ruben-wilssens/master_20-21/Code flowcharts/Packet_contents.pdf

Pkt length | Pkt type | Dest_ID | Source_ID | Audio samples (encrypted with voice key) | RSSI
Pkt length | Pkt type | Dest_ID | Source_ID | Voice key (encrypted with network key) | RSSI
Pkt length | Pkt type | Dest_ID | Source_ID | RSSI
Pkt length | Pkt type | Dest_ID | Source_ID | Audio samples | RSSI

Audio

Encrypted audio

Audio key

Keybit chosen

Pkt length | Pkt type | Dest_ID | Source_ID | RSSI

Keybit +Hamming
Hamming
Pkt length | Pkt type | Dest_ID | Source_ID | RSSI

Keybit +CRC
CRC
Pkt length | Pkt type | Dest_ID | Source_ID | RSSI

Keybit CRC response

Pkt length | Pkt type | Dest_ID | Source_ID | RSSI

Reply

Hamming | Index
