ruben-wilssens/master_20-21/Code flowcharts/Multi-user_flowchart.pdf

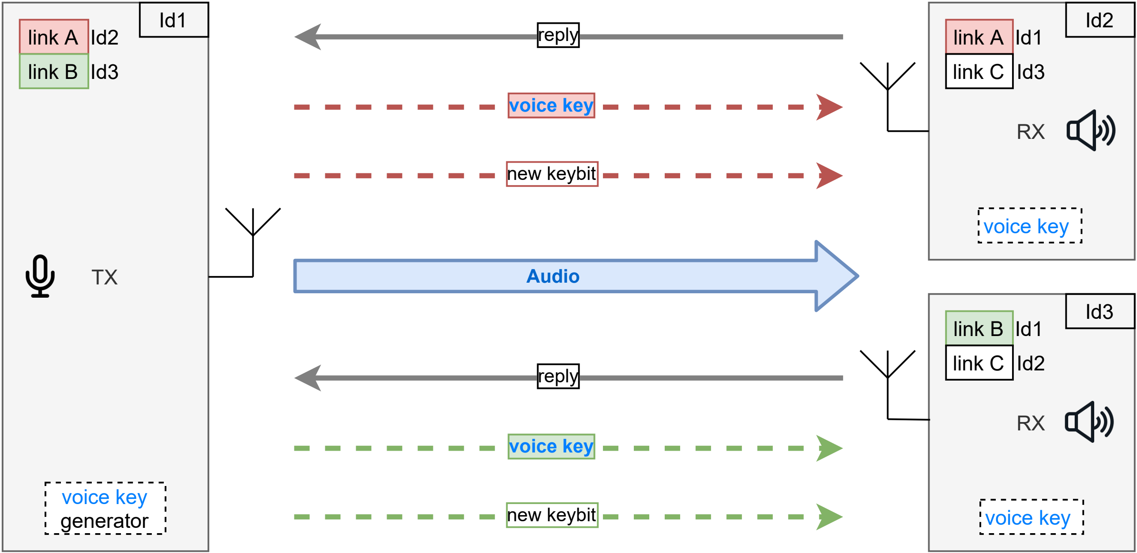
[picture p2: figure]
link A; link B; Audio; voice key generator; voice key; link C reply; new keybit; link C; reply
