ruben-wilssens/master_20-21/Images/PCB_bottom.png

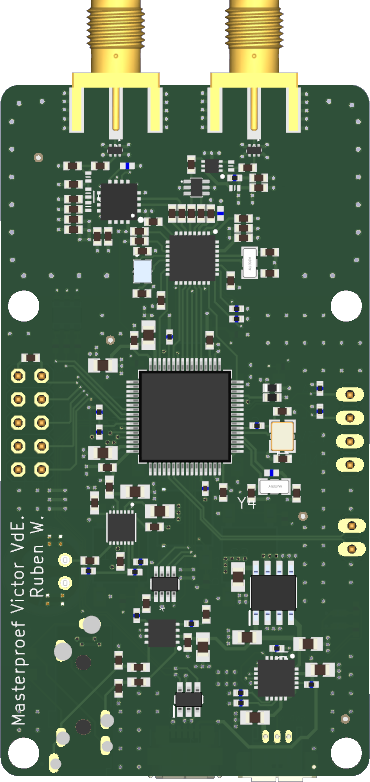
Images/PCB_bottom.png
