ruben-wilssens/master_20-21/Images/PCB_bottom_angle.png

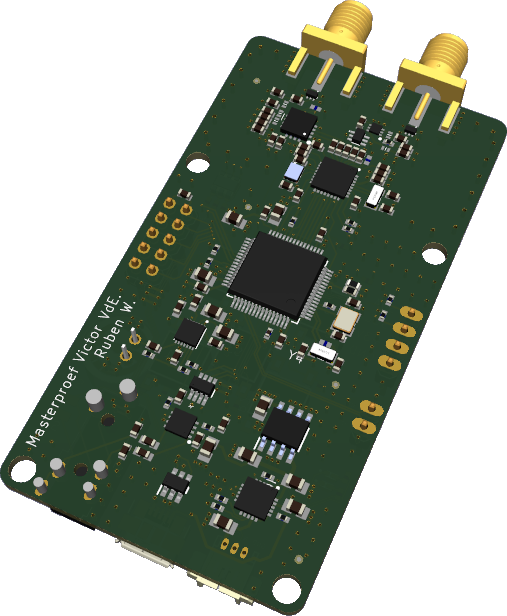
Images/PCB_bottom_angle.png
