ruben-wilssens/master_20-21/Images/PCB_top.png

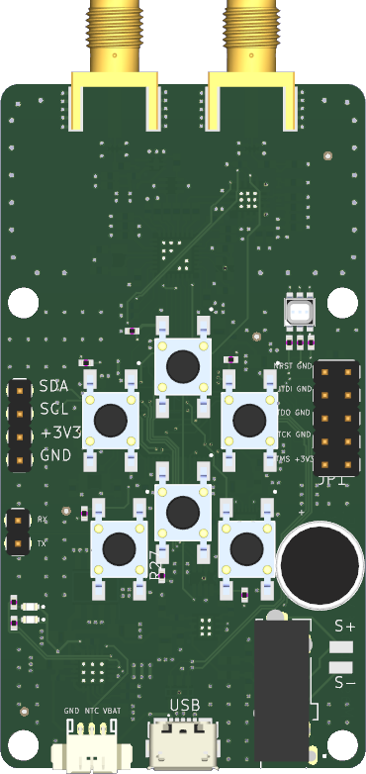
Images/PCB_top.png
