ruben-wilssens/master_20-21/Images/PCB_top_angle.png

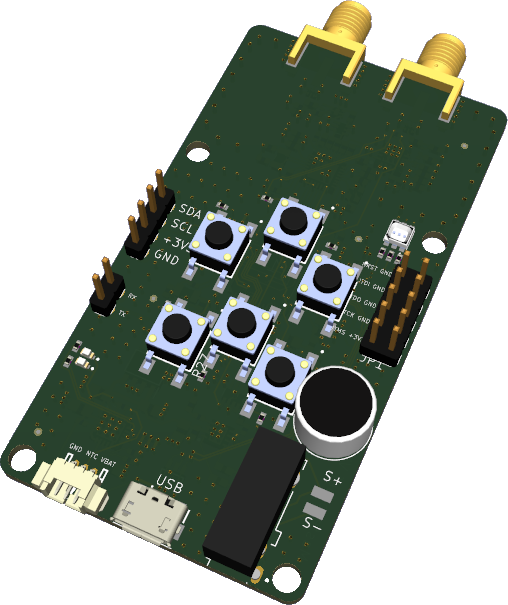
Images/PCB_top_angle.png
