ruben-wilssens/master_20-21/Code flowcharts/Abstract_code_flowchart.pdf

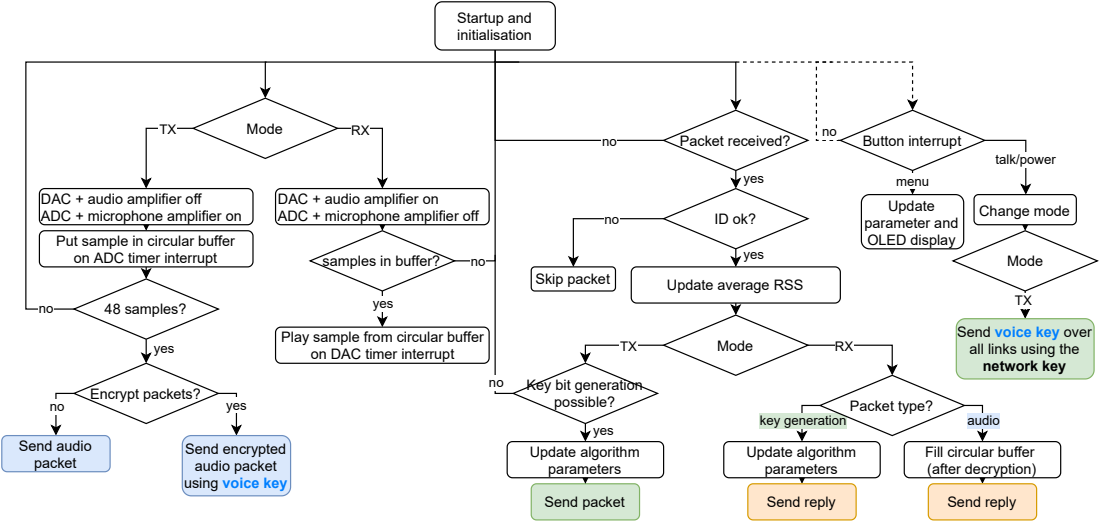
[picture p7: page 1]
Startup and initialisation; Mode; Skip packet; Update average RSS; yes; 48 samples?; Encrypt packets?; Send audio packet; Packet received?; key generation; audio; Packet type?; Update algorithm parameters; Key bit generation; possible?; Send packet; Send reply; menu; talk/power; Button interrupt; Update parameter and OLED display; Change mode

DAC + audio amplifier off
ADC + microphone amplifier on
Put sample in circular buffer
on ADC timer interrupt

DAC + audio amplifier on
ADC + microphone amplifier off

samples in buffer?

Send voice key over
all links using the
network key

Play sample from circular buffer
on DAC timer interrupt

Send encrypted
audio packet
using voice key

Fill circular buffer
(after decryption)
