ruben-wilssens/master_20-21/Code flowcharts/RX_mode_flowchart.pdf

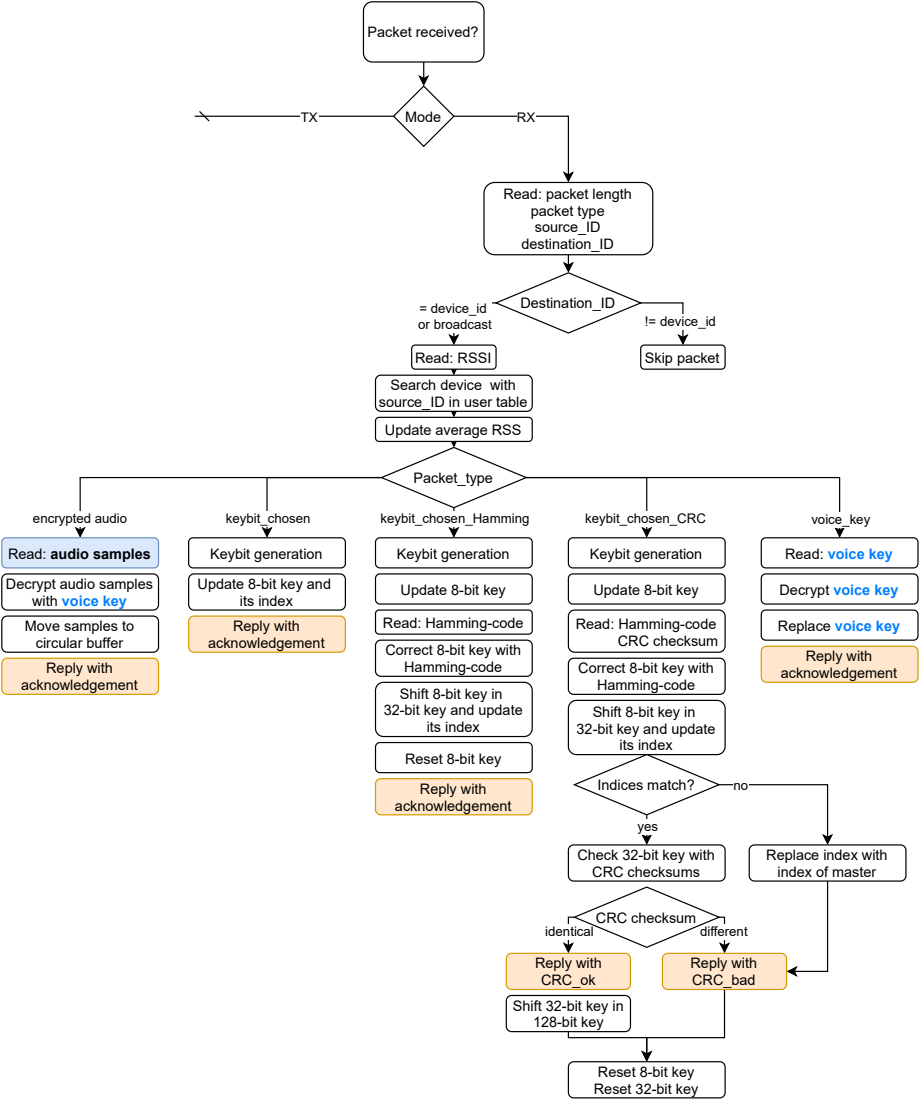
[picture p8: page 1]
Packet received?; Mode; Read: packet length packet type source_ID destination_ID; != device_id; = device_id or broadcast; Destination_ID; Read: RSSI; Skip packet; encrypted audio; keybit_chosen; keybit_chosen_Hamming; keybit_chosen_CRC; voice_key; Packet_type; Keybit generation; identical; different; CRC checksum; Reply with CRC_bad; yes; Indices match?

Search device with
source_ID in user table
Update average RSS

Read: audio samples
Decrypt audio samples
with voice key
Move samples to
circular buffer
Reply with
acknowledgement

Update 8-bit key and
its index

Read: voice key

Update 8-bit key

Decrypt voice key

Read: Hamming-code
Correct 8-bit key with
Hamming-code
Shift 8-bit key in
32-bit key and update

CRC checksum

Replace voice key

Reset 8-bit key

Check 32-bit key with
CRC checksums

Replace index with
index of master

CRC_ok
Shift 32-bit key in
128-bit key

Reset 32-bit key
