ruben-wilssens/master_20-21/Code flowcharts/TX_mode_flowchart.pdf

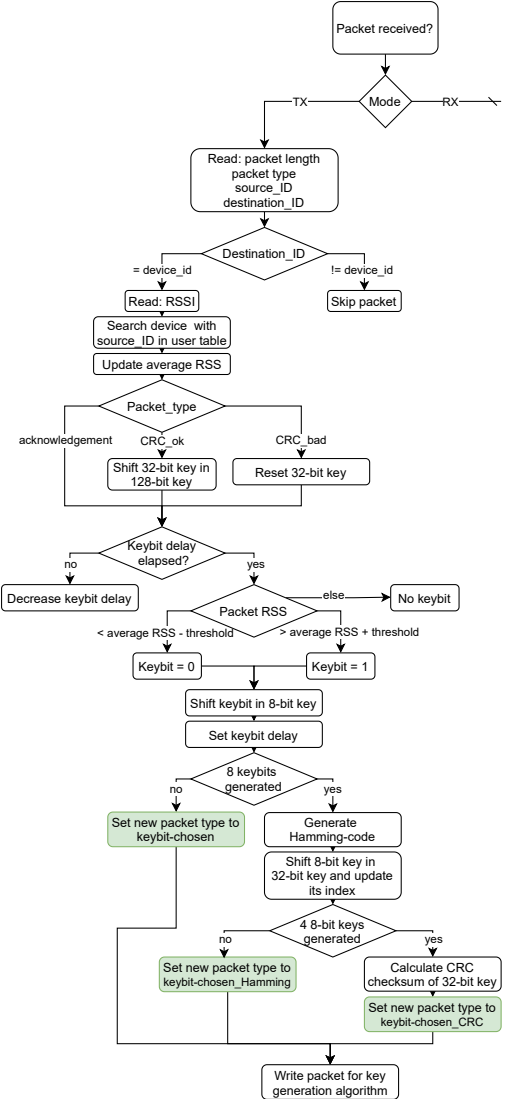
[picture p9: page 1]
Packet received?; Read: packet length packet type source_ID destination_ID; = device_id; != device_id; Destination_ID; Mode; Read: RSSI; Skip packet; acknowledgement; CRC_ok; CRC_bad; Packet_type; yes; Keybit delay elapsed?; < average RSS - threshold; > average RSS + threshold; else; Packet RSS; Keybit = 0; Keybit = 1; 8 keybits generated; 4 8-bit keys generated; No keybit

Search device with
source_ID in user table
Update average RSS

Shift 32-bit key in
128-bit key

Reset 32-bit key

Decrease keybit delay

Shift keybit in 8-bit key

Set keybit delay

Set new packet type to
keybit-chosen

Generate
Hamming-code
Shift 8-bit key in
32-bit key and update
its index

keybit-chosen_Hamming

Calculate CRC
checksum of 32-bit key
keybit-chosen_CRC

Write packet for key
generation algorithm
