ruben-wilssens/master_20-21/Master_1.0/Core/Src/main.c

/*
 *  main.c
 *
 *  Created on: February 2021
 *  Author: Ruben Wilssens & Victor Van der Elst
 *
 */

/* Includes ------------------------------------------------------------------*/
#include "main.h"
#include "usb_device.h"

/* USER CODE BEGIN Includes */
#include "usbd_cdc_if.h"
#include "ssh1106.h"
#include "OLED.h"
#include <math.h>
#include "CBUF.h"
#include "string.h"
/* USER CODE END Includes */

/* USER CODE BEGIN PTD */
typedef struct{
	uint8_t ID;						// network ID
	uint32_t RSSI_counter;			// received packets
	uint16_t RSSI_Mean;				// exponential moving average
	double RSSI_Mean_Double;

	uint8_t keybits_8bit;			// current number of bits of 8-bit key
	uint8_t key_8bit;				// current 8-bit key

	uint8_t keybytes_32bit;			// current number of new 8-bit keys in 32-bit key
	uint32_t key_32bit;				// current 32-bit key
	uint16_t key_counter_32bit;		// number of generated 32-bit keys

	uint8_t keywords_128bit;		// index for new 32-bit keys in 128-bit key
	uint32_t key_128bit[4];			// current 128-bit key
	uint32_t key_CRC_128bit[4];		// new 128-bit key with new 32-bit
	uint16_t key_counter;			// number of generated 128-bit keys

	uint8_t key_chosen_wait_timer;	// delay for new keybit
} device;

// Pointer to device struct
device *ptrdev;

device devices[] = {
{
		ID: 0x01,
		RSSI_counter: 0x00,
		RSSI_Mean: 0x0000,
		RSSI_Mean_Double:  0,
		keybits_8bit: 0,
		key_8bit: 0xA1,
		keybytes_32bit: 0,
		key_32bit: 0x80808080,
		key_counter_32bit: 0,
		keywords_128bit: 0,
		key_128bit: {0x2B7E1516,0x28AED2A6,0xABF71588,0x09CF4F3C},
		key_CRC_128bit: {0x2B7E1516,0x28AED2A6,0xABF71588,0x09CF4F3C},
		key_counter: 0x00,
		key_chosen_wait_timer: 0
},
{
		ID: 0x02,
		RSSI_counter: 0x00,
		RSSI_Mean: 0x0000,
		RSSI_Mean_Double:  0,
		keybits_8bit: 0,
		key_8bit: 0xA1,
		keybytes_32bit: 0,
		key_32bit: 0x80808080,
		key_counter_32bit: 0,
		keywords_128bit: 0,
		key_128bit: {0x2B7E1516,0x28AED2A6,0xABF71588,0x09CF4F3C},
		key_CRC_128bit: {0x2B7E1516,0x28AED2A6,0xABF71588,0x09CF4F3C},
		key_counter: 0x00,
		key_chosen_wait_timer: 0
}};

/* USER CODE END PTD */

/* USER CODE BEGIN PD */
volatile uint32_t time_start, time_end, time_diff;
#define TIME_MEASURE_START time_start = SysTick->VAL
#define TIME_MEASURE_STOP time_end = SysTick->VAL; \
		time_diff = time_start - time_end

/*
// Start point for SysTick
HAL_SYSTICK_Config(0xFFFFFFF);
TIME_MEASURE_START;
...
TIME_MEASURE_STOP;
*/

/* USER CODE END PD */

ADC_HandleTypeDef hadc1;

CRC_HandleTypeDef hcrc;

CRYP_HandleTypeDef hcryp;
__ALIGN_BEGIN static const uint32_t pKeyCRYP[4] __ALIGN_END = {
                            0x2B7E1516,0x28AED2A6,0xABF71588,0x09CF4F3C};

DAC_HandleTypeDef hdac;

I2C_HandleTypeDef hi2c1;

RTC_HandleTypeDef hrtc;

SPI_HandleTypeDef hspi1;
SPI_HandleTypeDef hspi2;

TIM_HandleTypeDef htim1;
TIM_HandleTypeDef htim2;
TIM_HandleTypeDef htim3;
TIM_HandleTypeDef htim5;
TIM_HandleTypeDef htim7;
TIM_HandleTypeDef htim9;
TIM_HandleTypeDef htim11;

UART_HandleTypeDef huart5;

/* USER CODE BEGIN PV */

/* ---Default settings--- */

char settings_mode = 'R';						// mode can be R (RX) or T (TX)
#define settings_audiosamples_length 48			// samplecount per audio packet -> packetrate = 8000^-1 * settings_audiosamples_length
uint8_t settings_volume = 30;					// digipot volume (keep < 50)
uint8_t HGM = 0;								// 0 = LGM LNA, 1 = HGM LNA
uint8_t settings_encryption = 1;				// 0 = off, 1 = on
uint8_t settings_threshold = 3;					// threshold for choosing keybits
double ALPHA = 0.1;								// weighting factor exponential moving average
const uint8_t settings_keybit_delay = 4;		// packets between new possible keybit



uint8_t encryption_byte = 0;					// new packet type

uint8_t dest_ID = 0xFF;							// current destination address
const uint8_t source_ID = 0x01;					// identification address device
const uint8_t broadcast_ID = 0xFF;				// broadcast address

uint8_t transmit_voice_key = 0;
const uint32_t voice_key_device[4] 	= {0x2B7E1516,0x28AED2A6,0xABF71588,0x09CF4F3C}; // voice key of device (extra: generate new one with RNG)
uint32_t voice_key[4] 				= {0x2B7E1516,0x28AED2A6,0xABF71588,0x09CF4F3C}; // current active voice key

/* ---OLED Variabels--- */
uint8_t settings_debugscreen = 0; 						// debug flag (unused)
uint8_t LBO = 1;										// low battery indicator flag
uint8_t menu = 4; 										// menu flag: 4 = credit screen
uint8_t update_oled = 0;								// OLED update flag
uint8_t settings_USB_print = 0;							// 0 = print new 32-bit key, 1 = print received RSS,

/* ---Packet settings--- */
const uint8_t packet_type_audio = 0xFE;
const uint8_t packet_type_audio_encrypted = 0xFF;
const uint8_t packet_type_voice_key = 0xBF;

const uint8_t packet_type_keybit_chosen = 0xAA;			// keybit chosen by TX
const uint8_t packet_type_keybit_chosen_Hamming = 0xAB; // 8th keybit chosen by TX + Hamming
const uint8_t packet_type_keybit_chosen_CRC = 0xAC; 	// 8th keybit chosen by TX + Hamming (4th byte) + CRC

const uint8_t packet_type_keybit_CRC_ok = 0xA0;			// CRC ok reply by RX
const uint8_t packet_type_keybit_CRC_bad = 0xB0;		// CRC bad reply by RX

const uint8_t packet_type_reply = 0x0F;

/* ---Packet reception (read)--- */
uint8_t Rx_packet_length;
uint8_t Rx_packet_type;
uint8_t Rx_from_ID;
uint8_t Rx_to_ID;
uint8_t Rx_data_length;
uint8_t Hamming;
uint32_t CRC_sum;
uint32_t CRC_c;
uint8_t CRC_array[4];
uint8_t keyword_index;
uint8_t Rx_RSSI;

uint8_t packet_valid;

/* ---External interrupts--- */
uint8_t INT_PACKET_RECEIVED = 0;				// ADF7242 interrupt
uint8_t INT_PACKET_SENT = 0;					// ADF7242 interrupt
uint16_t packets_received = 0;
uint16_t packets_received_prev = 0;
uint16_t packets_sent = 0;
uint16_t packets_sent_prev = 0;
uint32_t RSSI_prev = 0;

/* ---Button states for debouncing--- */
static volatile int POWER_state = 1;
static volatile int TALK_state = 1;
static volatile int UP_state = 1;
static volatile int DOWN_state = 1;
static volatile int LEFT_state = 1;
static volatile int RIGHT_state = 1;

uint8_t setup_switch = 0;						// hacking code (Tx->Rx bug)


/* ---Audio--- */
uint8_t adc_value = 0;
uint16_t adc_value_downsampled = 0;
uint32_t adc_counter = 0;
cbuf_handle_t audio_buffer_handle_t;
uint16_t cbuf_size = 0;
uint8_t data[settings_audiosamples_length];
uint8_t samples[settings_audiosamples_length];

/* ---Transceiver variables--- */
const uint32_t settings_frequency = 245000;		// ADF7242 frequency in [Hz/10kHz] -> 2,45 GHz
// Buffer starting address
uint8_t RX_BUFFER_BASE;
uint8_t TX_BUFFER_BASE;

uint8_t ADF_status;								// SPI status word return ADF7242


/* USER CODE END PV */

void SystemClock_Config(void);
static void MX_GPIO_Init(void);
static void MX_ADC1_Init(void);
static void MX_DAC_Init(void);
static void MX_I2C1_Init(void);
static void MX_SPI1_Init(void);
static void MX_SPI2_Init(void);
static void MX_TIM1_Init(void);
static void MX_TIM3_Init(void);
static void MX_UART5_Init(void);
static void MX_RTC_Init(void);
static void MX_TIM5_Init(void);
static void MX_TIM11_Init(void);
static void MX_TIM2_Init(void);
static void MX_TIM7_Init(void);
static void MX_TIM9_Init(void);
static void MX_CRYP_Init(void);
static void MX_CRC_Init(void);
/* USER CODE BEGIN PFP */

void HAL_GPIO_EXTI_Callback(uint16_t);					// external interrupt callback
void HAL_TIM_PeriodElapsedCallback(TIM_HandleTypeDef *);// timer elapsed callback
void HAL_ADC_ConvCpltCallback(ADC_HandleTypeDef*);		// ADC conversion complete callback

void startup(void);										// startup init device
void setup(void);										// setup device, display & transceiver

void digipotInit(uint8_t);								// set digipot volume
void LED_RGB_status(uint16_t , uint16_t , uint16_t );	// set RGB led color

void playAudio(void);									// transfer samples from audio buffer to DAC

void transmitVoiceKey(device *ptrdev);					// transmit voice key when becoming TX
void transmitAudioPacket(void);							// transmit audio packet if buffer filled with 48 packets
uint8_t readPacket(void);								// read received packet

void writeKeybitPacket(device*, uint8_t);				// write packet for network key generation

uint8_t Hamming_create(uint8_t);						// create parity bits of Hamming-code from 8-bit key
uint8_t Hamming_correct(uint8_t, uint8_t);				// correct 8-bit key with parity bits

void CRC_create(device*);								// create CRC checksum of new 128-bit network key with inserted 32-bit key
uint8_t CRC_check(device*);								// create CRC checksums

/* USER CODE END PFP */

/**
  * @brief  The application entry point.
  * @retval int
  */
int main(void)
{
  /* MCU Configuration--------------------------------------------------------*/

  /* Reset of all peripherals, Initializes the Flash interface and the Systick. */
  HAL_Init();

  /* Configure the system clock */
  SystemClock_Config();

  /* Initialize all configured peripherals */
  MX_GPIO_Init();
  MX_ADC1_Init();
  MX_DAC_Init();
  MX_I2C1_Init();
  MX_SPI1_Init();
  MX_SPI2_Init();
  MX_TIM1_Init();
  MX_TIM3_Init();
  MX_USB_DEVICE_Init();
  MX_UART5_Init();
  MX_RTC_Init();
  MX_TIM5_Init();
  MX_TIM11_Init();
  MX_TIM2_Init();
  MX_TIM7_Init();
  MX_TIM9_Init();
  MX_CRYP_Init();
  MX_CRC_Init();
  /* USER CODE BEGIN 2 */

  HAL_TIM_Base_Start(&htim7);

  // Start PWM timers for RGB led
  HAL_TIM_PWM_Start(&htim1, TIM_CHANNEL_1);
  HAL_TIM_PWM_Start(&htim3, TIM_CHANNEL_3);
  HAL_TIM_PWM_Start(&htim3, TIM_CHANNEL_4);

  LED_RGB_status(0, 0, 35);

  startup();
  digipotInit(settings_volume);

  // USB VCP variables
  int8_t buffer[60]; //25

  ptrdev= &devices[0];

  /* USER CODE END 2 */

  /* Infinite loop */
  /* USER CODE BEGIN WHILE */
  while (1){
	  if(transmit_voice_key){
		  HAL_Delay(1);
		  for(int i=0; i<sizeof(devices)/sizeof(devices[0]); i++){
			  transmitVoiceKey(&devices[i]);
			  HAL_Delay(2);
		  }
		  transmit_voice_key = 0;
	  }

	  if(setup_switch==1){
		  HAL_Delay(20);
		  ADF_set_Rx_mode();
		  setup_switch=0;
	  }

	  if (INT_PACKET_RECEIVED){
		  ADF_clear_Rx_flag(); //test
		  while(ADF_SPI_READY()==0);
		  INT_PACKET_RECEIVED = 0;

		  if (settings_mode == 'R'){
			  ADF_set_Rx_mode(); //added
			  while(ADF_SPI_READY()==0);
			  packet_valid = readPacket();

			  if(packet_valid){
				  // Point to correct device with Rx_from_ID
				  if(Rx_from_ID < sizeof(devices)/sizeof(devices[0])){
					  if(Rx_from_ID == devices[Rx_from_ID].ID){
						  ptrdev = &devices[Rx_from_ID];
					  }
				  }
				  else{
					  //throw error + do not execute code below
				  }
				  if (!(ptrdev->RSSI_counter)){
					  ptrdev->RSSI_Mean_Double = Rx_RSSI;
					  ptrdev->RSSI_Mean = round(ptrdev->RSSI_Mean_Double);
				  }
				  else{
					  ptrdev->RSSI_Mean_Double = (ALPHA*Rx_RSSI) + ((1-ALPHA)*ptrdev->RSSI_Mean_Double);
					  ptrdev->RSSI_Mean = round(ptrdev->RSSI_Mean_Double);
				  }
				  (ptrdev->RSSI_counter)++;


				  if(settings_USB_print == 1){
					  // Transmit RSS & RSS_Mean over USB
					  sprintf(buffer, "R,%d,%d\r\n", (int8_t) Rx_RSSI, (int8_t) ptrdev->RSSI_Mean);
					  CDC_Transmit_FS((int8_t *)buffer, strlen(buffer));
				  }


				  if(Rx_packet_type == packet_type_keybit_chosen){
					  // Generate new keybit
					  if(Rx_RSSI <= ptrdev->RSSI_Mean){
						  if(ptrdev->keybits_8bit < 8){
							  (ptrdev->key_8bit) = ((ptrdev->key_8bit)<<1) | 0;
							  (ptrdev->keybits_8bit)++;
						  }
					  }
					  else if(Rx_RSSI > ptrdev->RSSI_Mean){
						  if(ptrdev->keybits_8bit < 8){
							  (ptrdev->key_8bit) = ((ptrdev->key_8bit)<<1) | 1;
							  (ptrdev->keybits_8bit)++;
						  }
					  }

					  encryption_byte = packet_type_reply;
				  }

				  else if(Rx_packet_type == packet_type_keybit_chosen_Hamming){
					  // Generate last keybit of 8-bit key
					  if(Rx_RSSI <= ptrdev->RSSI_Mean){
						  (ptrdev->key_8bit) = ((ptrdev->key_8bit)<<1) | 0;
					  }
					  else if(Rx_RSSI > ptrdev->RSSI_Mean){
						  (ptrdev->key_8bit) = ((ptrdev->key_8bit)<<1) | 1;
					  }

					  // Do a Hamming correction with Rx_Hamming_code
					  (ptrdev->key_8bit) = Hamming_correct(Hamming, ptrdev->key_8bit);

					  // Shift 8-bit key in 32-bit key + update parameters
					  ptrdev->key_32bit = ((ptrdev->key_32bit)<<8) | (ptrdev->key_8bit);
					  ptrdev->key_8bit = 0;
					  ptrdev->keybits_8bit = 0;
					  (ptrdev->keybytes_32bit)++;

					  encryption_byte = packet_type_reply;


					  /*
					  // Transmit over USB
					  uint8_t TxBuf[34];
					  sprintf(TxBuf, "R;%lu\r\n", (unsigned long) (ptrdev->key_32bit));
					  CDC_Transmit_FS((int8_t *)TxBuf, strlen(TxBuf));
					  */
				  }

				  else if(Rx_packet_type == packet_type_keybit_chosen_CRC){
					  // Generate last keybit of 8-bit key
					  if(Rx_RSSI <= ptrdev->RSSI_Mean){
						  (ptrdev->key_8bit) = ((ptrdev->key_8bit)<<1) | 0;
					  }
					  else if(Rx_RSSI > ptrdev->RSSI_Mean){
						  (ptrdev->key_8bit) = ((ptrdev->key_8bit)<<1) | 1;
					  }

					  // Do a Hamming correction with Rx_Hamming_code
					  (ptrdev->key_8bit) = Hamming_correct(Hamming, ptrdev->key_8bit);

					  // Shift 8-bit key in 32-bit key + update parameters
					  ptrdev->key_32bit = ((ptrdev->key_32bit)<<8) | (ptrdev->key_8bit);
					  ptrdev->key_8bit = 0;
					  ptrdev->keybits_8bit = 0;
					  (ptrdev->keybytes_32bit) = 0;

					  if(settings_USB_print == 0){
						  // Transmit key over USB
						  uint8_t TxBuf[60];
						  sprintf(TxBuf, "R;%lu\r\n", (unsigned long) (ptrdev->key_32bit));
						  CDC_Transmit_FS((int8_t *)TxBuf, strlen(TxBuf));
					  }

					  if(keyword_index != ptrdev->keywords_128bit){
						  // There is a missmatch in key index (because CRC_reply did not arrive)
						  ptrdev->keywords_128bit = keyword_index;
						  for(int i=0; i<4; i++){
							  ptrdev->key_CRC_128bit[i] = ptrdev->key_128bit[i];
						  }
					  }

					  // Generate CRC of new Rx-key + do CRC check with Tx CRC
					  ptrdev->key_CRC_128bit[ptrdev->keywords_128bit] = ptrdev->key_32bit;

					  if(CRC_check(ptrdev)==1){
						  // Insert 32-bit key in 128-bit key
						  ptrdev->key_128bit[ptrdev->keywords_128bit]=ptrdev->key_32bit;
						  // Update the 128-bit key index
						  (ptrdev->keywords_128bit)++;
						  if(ptrdev->keywords_128bit>3){
							  ptrdev->keywords_128bit = 0;
						  }
						  (ptrdev->key_counter)++;

						  encryption_byte = packet_type_keybit_CRC_ok;
					  }
					  else{
						  encryption_byte = packet_type_keybit_CRC_bad;
					  }
				  }

				  else if(Rx_packet_type == packet_type_audio_encrypted){
					  hcryp.Init.pKey = voice_key;
					  HAL_CRYP_Decrypt(&hcryp, data, settings_audiosamples_length, samples, 50);
					  for(uint8_t i = 0; i < settings_audiosamples_length; i++){
						  circular_buf_put_overwrite(audio_buffer_handle_t, samples[i]);
					  }
					  encryption_byte = packet_type_reply;
				  }
				  else if(Rx_packet_type == packet_type_audio){
					  for(uint8_t i = 0; i < settings_audiosamples_length; i++){
						  circular_buf_put_overwrite(audio_buffer_handle_t, data[i]);
					  }
					  encryption_byte = packet_type_reply; // not necessary, should be deleted
				  }

				  if(encryption_byte !=0){
					  writeKeybitPacket(ptrdev, encryption_byte);
					  encryption_byte = 0;
				  }

				  /*
				  // Transmit RSS & RSS_Mean over USB
				  sprintf(buffer, "%d,%d\r\n", (int8_t) Rx_RSSI, (int8_t) ptrdev->RSSI_Mean);
				  CDC_Transmit_FS((int8_t *)buffer, strlen(buffer));
				*/
			  }
		  }

		  else if (settings_mode == 'T'){
			  ADF_set_Rx_mode();
			  packet_valid = readPacket();
			  if((Rx_to_ID == source_ID) && packet_valid == 1){
				  // Point to correct device with Rx_from_ID
				  if(Rx_from_ID < sizeof(devices)/sizeof(devices[0]) && Rx_from_ID == devices[Rx_from_ID].ID){
					  ptrdev = &devices[Rx_from_ID];
				  }
				  else{
					  //throw error + do not execute code below
				  }
				  if (!(ptrdev->RSSI_counter)){
					  ptrdev->RSSI_Mean_Double = Rx_RSSI;
					  ptrdev->RSSI_Mean = round(ptrdev->RSSI_Mean_Double);
				  }
				  else{
					  ptrdev->RSSI_Mean_Double = (ALPHA*Rx_RSSI) + ((1-ALPHA)*ptrdev->RSSI_Mean_Double);
					  ptrdev->RSSI_Mean = round(ptrdev->RSSI_Mean_Double);
				  }
				  (ptrdev->RSSI_counter)++;


				  if(settings_USB_print == 1){
					  // Transmit RSS & RSS_Mean over USB
					  sprintf(buffer, "T,%d,%d\r\n", (int8_t) Rx_RSSI, (int8_t) ptrdev->RSSI_Mean);
					  CDC_Transmit_FS((int8_t *)buffer, strlen(buffer));
				  }


				  // ---Key generation algorithm TX---
				  // Wait for 100 RSSI values
				  if(ptrdev->RSSI_counter > 100){
					  // Delay for new keybit is passed
					  if (ptrdev->key_chosen_wait_timer == 0){
						  // RSS below threshold -> keybit = 0
						  if (Rx_RSSI < (ptrdev->RSSI_Mean - settings_threshold)){
							  if ((ptrdev->keybits_8bit) < 8){
								  ptrdev->key_8bit = ((ptrdev->key_8bit)<<1) | 0;
								  (ptrdev->keybits_8bit)++;
								  ptrdev->key_chosen_wait_timer = settings_keybit_delay;

								  encryption_byte = packet_type_keybit_chosen;
							  }
						  }
						  // RSS above threshold -> keybit = 1
						  else if (Rx_RSSI > (ptrdev->RSSI_Mean + settings_threshold)){
							  if ((ptrdev->keybits_8bit) < 8){
								  ptrdev->key_8bit = ((ptrdev->key_8bit)<<1) | 1;
								  (ptrdev->keybits_8bit)++;
								  ptrdev->key_chosen_wait_timer = settings_keybit_delay;

								  encryption_byte = packet_type_keybit_chosen;
							  }
						  }
					  }
					  else{
						  (ptrdev->key_chosen_wait_timer)--;
					  }

					  // Hamming
					  if(ptrdev->keybits_8bit == 8){
						  // Prepare Hamming-code
						  Hamming = Hamming_create(ptrdev->key_8bit);

						  // Shift 8-bit key in 32-bit key
						  ptrdev->key_32bit = ((ptrdev->key_32bit)<<8) | (ptrdev->key_8bit);
						  // Reset 8-bit key
						  ptrdev->key_8bit = 0;
						  ptrdev->keybits_8bit = 0;
						  // Update number of 8-bit keys in 32-bit key
						  (ptrdev->keybytes_32bit)++;

						  encryption_byte = packet_type_keybit_chosen_Hamming;
						  /*
						  // Transmit 32-bit key over USB
						  uint8_t TxBuf[34];
						  sprintf(TxBuf, "T;%lu\r\n", (unsigned long) (ptrdev->key_32bit));
						  CDC_Transmit_FS((int8_t *)TxBuf, strlen(TxBuf));
						  */
					  }

					  // CRC
					  if(ptrdev->keybytes_32bit == 4){
						  // calculate CRC
						  ptrdev->key_CRC_128bit[ptrdev->keywords_128bit] = ptrdev->key_32bit;
						  CRC_create(ptrdev);

						  // Update number of "new" 32-bit keys
						  (ptrdev->key_counter_32bit)++;
						  (ptrdev->keybytes_32bit) = 0;

						  if(settings_USB_print == 0){
							  // Transmit key over USB
							  uint8_t TxBuf[60];
							  sprintf(TxBuf, "T;%lu\r\n", (unsigned long) (ptrdev->key_32bit));
							  CDC_Transmit_FS((int8_t *)TxBuf, strlen(TxBuf));
						  }

						  encryption_byte = packet_type_keybit_chosen_CRC;
					  }
				  }

				  if(Rx_packet_type == packet_type_keybit_CRC_ok){
					  // Insert matching 32-bit key in 128-bit key
					  ptrdev->key_128bit[ptrdev->keywords_128bit]=ptrdev->key_32bit;
					  // Update the 128-bit key index
					  (ptrdev->keywords_128bit)++;
					  if(ptrdev->keywords_128bit>3){
						  ptrdev->keywords_128bit = 0;
					  }
					  (ptrdev->key_counter)++;

					  /*
					  // Transmit 32-bit key over USB
					  uint8_t TxBuf[34];
					  sprintf(TxBuf, "T;%lu\r\n", (unsigned long) (ptrdev->key_32bit));
					  CDC_Transmit_FS((int8_t *)TxBuf, strlen(TxBuf));
					  */
				  }

				  else if(Rx_packet_type == packet_type_keybit_CRC_bad){
					  asm("nop");;
				  }

				  if(encryption_byte !=0){
					  HAL_Delay(1);
					  writeKeybitPacket(ptrdev, encryption_byte);
					  encryption_byte = 0;
				  }

				  /*
				  // Transmit RSS & RSS_Mean over USB
				  sprintf(buffer, "%d %d\r\n", (int8_t) Rx_RSSI, (int8_t) ptrdev->RSSI_Mean);
				  CDC_Transmit_FS((int8_t *)buffer, strlen(buffer));
				  */
			  }
		  }
	  }

	  if (INT_PACKET_SENT){
		  INT_PACKET_SENT = 0;
		  ADF_clear_Tx_flag(); //test
		  while(ADF_SPI_READY()==0);
		  if (settings_mode == 'R'){
			  //while(ADF_SPI_READY()==0);
			  //ADF_set_Rx_mode();
		  }
	  }

	  if (settings_mode == 'T') {
		  // Send audio packet whenever there are enough samples in circular buffer
		  cbuf_size = circular_buf_size(audio_buffer_handle_t);
		  if (cbuf_size > settings_audiosamples_length){
			  transmitAudioPacket();
		  }
	  }

	  if (update_oled){
		  update_oled=0;
		  OLED();
		  if(menu==2){
			  digipotInit(settings_volume);
		  }
	  }

    /* USER CODE END WHILE */

    /* USER CODE BEGIN 3 */
  }
  /* USER CODE END 3 */
}

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
/* USER CODE BEGIN 4 */

void delay_us (uint16_t us){
	__HAL_TIM_SET_COUNTER(&htim7,0);  // set the counter value a 0
	while (__HAL_TIM_GET_COUNTER(&htim7) < us);  // wait for the counter to reach the us input in the parameter
}


/* Callback external interrupts */
void HAL_GPIO_EXTI_Callback(uint16_t GPIO_Pin){

	switch(GPIO_Pin){
		case ADF7242_IRQ1_Pin:
			INT_PACKET_SENT = 1;
			packets_sent++;
			ADF_clear_Tx_flag();
			break;

		case ADF7242_IRQ2_Pin:
			INT_PACKET_RECEIVED = 1;
			packets_received++;
			delay_us(10);//6
			ADF_clear_Rx_flag();
			break;

		case BTN_TALK_Pin:
			if(TALK_state){
				TALK_state = 0;
				HAL_TIM_Base_Start_IT(&htim11);
			}
			break;

		case BTN_UP_Pin:
			if(UP_state){
				UP_state = 0;
				HAL_TIM_Base_Start_IT(&htim11);
			}
			break;


		case BTN_LEFT_Pin:
			if(LEFT_state){
				LEFT_state = 0;
				HAL_TIM_Base_Start_IT(&htim11);
			}
			break;

		case BTN_RIGHT_Pin:
			if(RIGHT_state){
				RIGHT_state = 0;
				HAL_TIM_Base_Start_IT(&htim11);
			}
			break;

		case BTN_DOWN_Pin:
			if(DOWN_state){
				DOWN_state = 0;
				HAL_TIM_Base_Start_IT(&htim11);
			}
			break;

		case BTN_PWR_Pin:
			if(POWER_state){
				POWER_state = 0;
				HAL_TIM_Base_Start_IT(&htim11);
			}
			break;

		case LBO_Pin:
			/*
			if(HAL_GPIO_ReadPin(LBO_GPIO_Port, LBO_Pin)){
				LBO=1;
				LED_RGB_status(0,15,0);
			}
			else{
				LBO=0;
				LED_RGB_status(15,0,0);
			}*/
			update_oled = 1;
			break;

	}
}


/* Callback timers */
void HAL_TIM_PeriodElapsedCallback(TIM_HandleTypeDef *htim){

	// Play audio samples on DAC
	if (htim->Instance == TIM2){
		playAudio();
	}

	// Timer for external interrupts (buttons)
	if (htim->Instance == TIM11){

		// Power button pressed
		if (HAL_GPIO_ReadPin(BTN_PWR_GPIO_Port, BTN_PWR_Pin)){
			// POWER_state = 1;

			ADF_sleep();
			OLED_shutdown();
			HAL_GPIO_WritePin(CLASS_D_SHDN_GPIO_Port, CLASS_D_SHDN_Pin, GPIO_PIN_RESET);
			HAL_GPIO_WritePin(MIC_SHDN_GPIO_Port, MIC_SHDN_Pin, GPIO_PIN_RESET);
			HAL_TIM_Base_Stop_IT(&htim2);
			HAL_DAC_Stop(&hdac, DAC_CHANNEL_1);
			HAL_TIM_Base_Stop_IT(&htim1);
			HAL_TIM_Base_Stop_IT(&htim3);
			HAL_TIM_OC_Stop(&htim5, TIM_CHANNEL_1);
			HAL_ADC_Stop_IT(&hadc1);

			HAL_Delay(250);

			HAL_PWR_EnableWakeUpPin(PWR_WAKEUP_PIN1);
			HAL_PWR_EnterSTANDBYMode();

			HAL_TIM_Base_Stop_IT(&htim11);
		}

		// Talk button pressed
		if (HAL_GPIO_ReadPin(BTN_TALK_GPIO_Port, BTN_TALK_Pin)){
			//TALK_state = 1;
			// Change mode
			if (settings_mode == 'R'){
				settings_mode = 'T';
			}
			else if (settings_mode == 'T'){
				settings_mode = 'R';
			}

			HAL_TIM_Base_Stop_IT(&htim11);
			// Initialize correct timers, components, interrupts for selected mode
			// HAL_Delay(1); // added later, not sure if needed
			setup();
		}

		// Up button pressed
		if (HAL_GPIO_ReadPin(BTN_UP_GPIO_Port, BTN_UP_Pin)){
			//UP_state = 1;
			switch(menu){
				case 0:
					// Encryption
					if(settings_encryption){
						settings_encryption = 0;
					}
					else{
						settings_encryption = 1;
					}
					break;

				case 1:
					if (HGM){
						LED_RGB_status(0, 0, 10);
						HGM = 0;
						HAL_GPIO_WritePin(PA_LNA_HGM_GPIO_Port, PA_LNA_HGM_Pin, GPIO_PIN_SET);
					}
					else{
						LED_RGB_status(15, 0, 20);
						HGM = 1;
						HAL_GPIO_WritePin(PA_LNA_HGM_GPIO_Port, PA_LNA_HGM_Pin, GPIO_PIN_RESET);
					}
					break;

				case 2:
					// VOLUME
					settings_volume = (settings_volume + 5) % 55;
					break;

				case 3:
					// Threshold
					settings_threshold = (settings_threshold + 1) % 9;
					break;

				case 4:
					break;

				case 5:
					// USB print
					if(settings_USB_print){
						settings_USB_print = 0;
					}
					else{
						settings_USB_print = 1;
					}
					break;
			}

			update_oled = 1;
			HAL_TIM_Base_Stop_IT(&htim11);
		}

		// Down button pressed
		if (HAL_GPIO_ReadPin(BTN_DOWN_GPIO_Port, BTN_DOWN_Pin)){
			//DOWN_state = 1;
			switch(menu){
				case 0:
					// Encryption
					if(settings_encryption){
						settings_encryption = 0;
					}
					else{
						settings_encryption = 1;
					}
					break;

				case 1:
					if (HGM){
						LED_RGB_status(0, 0, 10);
						HGM = 0;
						HAL_GPIO_WritePin(PA_LNA_HGM_GPIO_Port, PA_LNA_HGM_Pin, GPIO_PIN_SET);
					}
					else{
						LED_RGB_status(15, 0, 20);
						HGM = 1;
						HAL_GPIO_WritePin(PA_LNA_HGM_GPIO_Port, PA_LNA_HGM_Pin, GPIO_PIN_RESET);
					}
					break;

				case 2:
					// VOLUME
					settings_volume = (settings_volume + (55 - 5)) % 55;
					break;

				case 3:
					// Threshold
					settings_threshold = (settings_threshold + (9 - 1)) % 9;
					break;

				case 4:
					break;
				case 5:
					// USB print
					if(settings_USB_print){
						settings_USB_print = 0;
					}
					else{
						settings_USB_print = 1;
					}
					break;
			}

			update_oled = 1;
			HAL_TIM_Base_Stop_IT(&htim11);
		}

		// Left button pressed
		if (HAL_GPIO_ReadPin(BTN_LEFT_GPIO_Port, BTN_LEFT_Pin)){
			//LEFT_state = 1;

			menu = (menu + (6 - 1)) % 6;

			update_oled = 1;
			HAL_TIM_Base_Stop_IT(&htim11);
		}

		// Right button pressed
		if (HAL_GPIO_ReadPin(BTN_RIGHT_GPIO_Port, BTN_RIGHT_Pin)){
			//RIGHT_state = 1;

			menu = (menu + 1) % 6;

			update_oled = 1;
			HAL_TIM_Base_Stop_IT(&htim11);
		}

		POWER_state = 1;
		TALK_state = 1;
		UP_state = 1;
		DOWN_state = 1;
		LEFT_state = 1;
		RIGHT_state = 1;
	}

	/*
	if(settings_debugscreen){
		if(htim->Instance == TIM9){
			if(settings_mode == 'R'){
				OLED_clear_screen();
				OLED_print_status(settings_mode);
				OLED_print_variable("Packets T:  ", packets_sent, 5, 20);
				OLED_print_variable("Packets R:  ", packets_received, 5, 30);
				OLED_print_variable("Packet/s R: ", packets_received-packets_received_prev, 5, 40);
				OLED_update();
				packets_received_prev = packets_received;
			}
			else if(settings_mode == 'T'){
				OLED_clear_screen();
				OLED_print_status(settings_mode);
				OLED_print_variable("Packets T:  ", packets_sent, 5, 20);
				OLED_print_variable("Packets R:  ", packets_received, 5, 30);
				OLED_print_variable("Packet/s T: ", packets_sent-packets_sent_prev, 5, 40);
				OLED_update();
				packets_sent_prev = packets_sent;
			}
		}
	}
	*/

}


/* Callback ADC conversion */
void HAL_ADC_ConvCpltCallback(ADC_HandleTypeDef* hadc){
	/*
	// ADC running at 8 kHz (TIM5: (2625*2-1))
	adc_value = HAL_ADC_GetValue(&hadc1);
	circular_buf_put_overwrite(audio_buffer_handle_t, adc_value);
	*/

	// ADC running at 16 kHz (TIM5: (2625-1)), with sample averaging to 8 kHz to improve SNR
	if(adc_counter%2){
		adc_value = HAL_ADC_GetValue(&hadc1);
		adc_counter++;
	}
	else{
		adc_value_downsampled = HAL_ADC_GetValue(&hadc1);
		adc_value_downsampled += adc_value;
		adc_value_downsampled /= 2;
		circular_buf_put_overwrite(audio_buffer_handle_t, adc_value_downsampled);
		adc_counter++;
	}

}


void startup(void){
	// Clear PWR wake up Flag
	HAL_PWR_DisableWakeUpPin(PWR_WAKEUP_PIN1);
	__HAL_PWR_CLEAR_FLAG(PWR_FLAG_WU);
	__HAL_PWR_CLEAR_FLAG(PWR_FLAG_SB);

	OLED_init();
	OLED_print_credits();
	OLED_print_status(settings_mode);
	OLED_update();

	// Setup registers for transceiver
	ADF_Init(settings_frequency);

	HAL_Delay(1000);

	ADF_set_turnaround_Tx_Rx();

	// Make audio buffer for 400 8-bit samples
	uint16_t buffer_size = 400;
	uint16_t *buffer = malloc(buffer_size * sizeof(uint16_t));
	audio_buffer_handle_t = circular_buf_init(buffer, buffer_size);

	// Setup for MCU
	setup();
	if(HAL_GPIO_ReadPin(LBO_GPIO_Port, LBO_Pin)){
		LBO=1;
	}
	else{
		LBO=0;
	}
	setup_switch=0;
	ADF_set_Rx_mode(); //werkte 21/03

}


/* ---Called upon startup or talk-button press--- */
void setup(){
	// Reset buffer
	circular_buf_reset(audio_buffer_handle_t);
	switch(settings_mode){
		case 'T':
			LED_RGB_status(0, 10, 0);

			ADF_clear_Rx_flag(); //test
			ADF_clear_Tx_flag(); //test

			// Stop the DAC interface and timer2 (8 kHz)
			HAL_DAC_Stop(&hdac, DAC_CHANNEL_1);
			HAL_TIM_Base_Stop_IT(&htim2);

			// Shutdown Class D audio amplifier
			HAL_GPIO_WritePin(CLASS_D_SHDN_GPIO_Port, CLASS_D_SHDN_Pin, GPIO_PIN_RESET); //GPIO_PIN_RESET
			// Enable microphone preamplifier
			HAL_GPIO_WritePin(MIC_SHDN_GPIO_Port, MIC_SHDN_Pin, GPIO_PIN_SET);

			// Start timer5 (16 kHz) and ADC interrupt triggered by TIM5
			HAL_TIM_OC_Start(&htim5, TIM_CHANNEL_1);
			HAL_ADC_Start_IT(&hadc1);

			//update_oled = 1;
			//HAL_TIM_Base_Start_IT(&htim9);

			//transmit_voice_key = 1;

			break;

		case 'R':
			//setup_switch = 1;
			LED_RGB_status(0, 0, 10);

			ADF_clear_Rx_flag(); //test
			ADF_clear_Tx_flag(); //test

			// Stop timer5 (16 kHz) and ADC interrupt triggered by TIM5
			HAL_TIM_OC_Stop(&htim5, TIM_CHANNEL_1);
			HAL_ADC_Stop_IT(&hadc1);

			// Shutdown microphone preamplifier
			HAL_GPIO_WritePin(MIC_SHDN_GPIO_Port, MIC_SHDN_Pin, GPIO_PIN_RESET);
			// Enable Class D audio amplifier
			HAL_GPIO_WritePin(CLASS_D_SHDN_GPIO_Port, CLASS_D_SHDN_Pin, GPIO_PIN_SET);

			// Start the DAC interface and timer2 (8 kHz)
			HAL_DAC_Start(&hdac, DAC_CHANNEL_1);
			HAL_TIM_Base_Start_IT(&htim2);

			//update_oled = 1;
			//ADF_set_Rx_mode(); //werkte 21/03
			break;
	}

}

void digipotInit(uint8_t volume){
	uint8_t value[1];
	value[0]= volume;
	HAL_GPIO_WritePin(DPOT_CS_GPIO_Port, DPOT_CS_Pin, GPIO_PIN_RESET);
	HAL_SPI_Transmit(&hspi2, value, 1, 50);
	HAL_GPIO_WritePin(DPOT_CS_GPIO_Port, DPOT_CS_Pin, GPIO_PIN_SET);
}


void LED_RGB_status(uint16_t red, uint16_t green, uint16_t blue){
	// Brightness limiting due to low resistance values
	if(red>20){
		red = 20;
	}
	if(green>30){
		green = 30;
	}
	if(blue>35){
		blue = 35;
	}
	htim1.Instance->CCR1 = red;
	htim3.Instance->CCR4 = green;
	htim3.Instance->CCR3 = blue;
}

void transmitVoiceKey(device *ptrdev){
	uint8_t key[16];
	uint8_t key_encrypted[16];

	// Packet length (1byte), packet type (1byte), dest_ID, source_ID (1byte), RSSI byte (1byte) + 16 bytes with voice key
	uint8_t packet_total_length = 5 + 16;

	// SPI_PKT_WR, packet total length, packet type, ID
	uint8_t header[] = {0x10, packet_total_length, packet_type_voice_key, dest_ID = ptrdev->ID, source_ID};

	// Read voice key and store as bytes
	for(uint8_t i = 0; i < 4; i++){
		key[i*4]   	 =  ptrdev->key_128bit[i] & 0x000000ff;
		key[(i*4)+1] = (ptrdev->key_128bit[i] & 0x0000ff00)>>8;
		key[(i*4)+2] = (ptrdev->key_128bit[i] & 0x00ff0000)>>16;
		key[(i*4)+3] = (ptrdev->key_128bit[i] & 0xff000000)>>24;
	}

	// Set correct network key and encrypt the voice key
	//CRYP_SetKey(&hcryp, ptrdev->key_128bit);
	hcryp.Init.pKey = ptrdev->key_128bit;
	HAL_CRYP_Encrypt(&hcryp, key, 16, key_encrypted, 50); //blocking

	// ---Write data to packet RAM---
	HAL_GPIO_WritePin(ADF7242_CS_GPIO_Port, ADF7242_CS_Pin, GPIO_PIN_RESET);
	HAL_SPI_Transmit_IT(&hspi1, header, 5);

	for(uint8_t i = 0; i < 16; i++){
		HAL_SPI_Transmit_IT(&hspi1, &key_encrypted[i], 1);
	}

	HAL_GPIO_WritePin(ADF7242_CS_GPIO_Port, ADF7242_CS_Pin, GPIO_PIN_SET);

	// Transmit packet
	ADF_set_Tx_mode();

}

void transmitAudioPacket(void){
	uint8_t packet_type;
	uint8_t cbuf_ret = 0;

	// Packet length (1byte), packet type (1byte), dest_ID, source_ID (1byte), RSSI byte (1byte)
	uint8_t packet_total_length = 5 + settings_audiosamples_length;

	if(settings_encryption){
		packet_type = packet_type_audio_encrypted;
	}
	else{
		packet_type = packet_type_audio;
	}

	// SPI_PKT_WR, packet total length, packet type, ID
	uint8_t header[] = {0x10, packet_total_length, packet_type, dest_ID = 0xFF, source_ID};

	// Read samples from audio buffer
	for(uint8_t i = 0; i < settings_audiosamples_length; i++){
		cbuf_ret = circular_buf_get(audio_buffer_handle_t, &samples[i]);
	}

	// Encryption
	if(settings_encryption){
		//CRYP_SetKey(&hcryp, voice_key_device);
		hcryp.Init.pKey = voice_key_device;
		HAL_CRYP_Encrypt(&hcryp, samples, settings_audiosamples_length, data, 50); //blocking
	}

	// ---Write data to packet RAM---
	HAL_GPIO_WritePin(ADF7242_CS_GPIO_Port, ADF7242_CS_Pin, GPIO_PIN_RESET);
	HAL_SPI_Transmit_IT(&hspi1, header, 5);

	if(settings_encryption){
		for(uint8_t i = 0; i < settings_audiosamples_length; i++){
			HAL_SPI_Transmit_IT(&hspi1, &data[i], 1);
		}
	}
	else{
		for(uint8_t i = 0; i < settings_audiosamples_length; i++){
			HAL_SPI_Transmit_IT(&hspi1, &samples[i], 1);
		}
	}

	HAL_GPIO_WritePin(ADF7242_CS_GPIO_Port, ADF7242_CS_Pin, GPIO_PIN_SET);

	// Transmit packet
	ADF_set_Tx_mode();

}

uint8_t readPacket(void){
	uint8_t valid = 0;
	// SPI_PKT_RD and SPI_NOP command
	uint8_t SPI_commands[] = {0x30, 0xff};

	while (ADF_SPI_READY() == 0);

	HAL_GPIO_WritePin(ADF7242_CS_GPIO_Port, ADF7242_CS_Pin, GPIO_PIN_RESET);
	HAL_SPI_Transmit_IT(&hspi1, SPI_commands, 2);

	HAL_SPI_Receive_IT(&hspi1, &Rx_packet_length, 1);
	HAL_SPI_Receive_IT(&hspi1, &Rx_packet_type, 1);
	HAL_SPI_Receive_IT(&hspi1, &Rx_to_ID, 1);
	HAL_SPI_Receive_IT(&hspi1, &Rx_from_ID, 1);

	if(Rx_to_ID == broadcast_ID){
		if(Rx_packet_type == packet_type_audio_encrypted || Rx_packet_type == packet_type_audio){
			for(uint8_t i = 0; i < settings_audiosamples_length; i++){
				HAL_SPI_Receive_IT(&hspi1, &data[i], 1);
			}

			HAL_SPI_Receive_IT(&hspi1, &Rx_RSSI, 1);
			HAL_GPIO_WritePin(ADF7242_CS_GPIO_Port, ADF7242_CS_Pin, GPIO_PIN_SET);
			valid = 1;
		}
	}
	else if (Rx_to_ID == source_ID){
		// Reply from audio packet
		if(Rx_packet_type == packet_type_reply){
			HAL_SPI_Receive_IT(&hspi1, &Rx_RSSI, 1);
			valid = 1;
			asm("nop");;
		}
		// Keybit chosen by TX
		else if(Rx_packet_type == packet_type_keybit_chosen){
			HAL_SPI_Receive_IT(&hspi1, &Rx_RSSI, 1);
			valid = 1;
			asm("nop");;
		}
		// Keybit chosen by TX with Hamming-code
		else if(Rx_packet_type == packet_type_keybit_chosen_Hamming){
			HAL_SPI_Receive_IT(&hspi1, &Hamming, 1);
			HAL_SPI_Receive_IT(&hspi1, &Rx_RSSI, 1);
			valid = 1;
			asm("nop");;
		}
		// Keybit chosen by TX with Hamming-code and CRC check
		else if(Rx_packet_type == packet_type_keybit_chosen_CRC){
			HAL_SPI_Receive_IT(&hspi1, &Hamming, 1);
			for(int i=0; i<4; i++){
				HAL_SPI_Receive_IT(&hspi1, &CRC_array[i], 1);
			}
			HAL_SPI_Receive_IT(&hspi1, &keyword_index, 1);
			HAL_SPI_Receive_IT(&hspi1, &Rx_RSSI, 1);
			valid = 1;
			asm("nop");;

		}
		else if (Rx_packet_type == packet_type_keybit_CRC_ok){
			HAL_SPI_Receive_IT(&hspi1, &Rx_RSSI, 1);
			valid = 1;
			asm("nop");;
		}
		else if (Rx_packet_type == packet_type_keybit_CRC_bad){
			HAL_SPI_Receive_IT(&hspi1, &Rx_RSSI, 1);
			valid = 1;
			asm("nop");;
		}
		// Transmission of voice-key by TX to slaves
		else if (Rx_packet_type == packet_type_voice_key){
			uint32_t val;
			uint8_t byte;
			for(uint8_t i = 0; i < 4; i++){
				val = 0;
				for(uint8_t b=0 ; b < 4 ;b++){
					HAL_SPI_Receive_IT(&hspi1, byte, 1);
					val = (val << 8) | byte;
				}
				voice_key[i] = val;
			}
			HAL_SPI_Receive_IT(&hspi1, &Rx_RSSI, 1);
			valid = 1;
			asm("nop");;
		}
		HAL_GPIO_WritePin(ADF7242_CS_GPIO_Port, ADF7242_CS_Pin, GPIO_PIN_SET);
	}
	HAL_GPIO_WritePin(ADF7242_CS_GPIO_Port, ADF7242_CS_Pin, GPIO_PIN_SET);
	return valid;
}


void writeKeybitPacket(device *ptrdev, uint8_t keybit_type){
	// Packet length (1byte), packet type (1byte), dest_ID, source_ID (1byte), RSSI byte (1byte)
	uint8_t packet_total_length = 5;

	if(keybit_type == packet_type_keybit_chosen){
		uint8_t header[] = {0x10, packet_total_length, packet_type_keybit_chosen, dest_ID = ptrdev->ID , source_ID};

		// Write data to packet RAM
		HAL_GPIO_WritePin(ADF7242_CS_GPIO_Port, ADF7242_CS_Pin, GPIO_PIN_RESET);
		HAL_SPI_Transmit_IT(&hspi1, header, sizeof(header)/sizeof(header[0]));
		HAL_GPIO_WritePin(ADF7242_CS_GPIO_Port, ADF7242_CS_Pin, GPIO_PIN_SET);
		ADF_set_Tx_mode();
	}
	else if(keybit_type == packet_type_keybit_chosen_Hamming){
		//packet length + Hamming-code (1byte)
		packet_total_length+=1;

		uint8_t header[] = {0x10, packet_total_length, packet_type_keybit_chosen_Hamming, dest_ID = ptrdev->ID , source_ID, Hamming};
		// Write data to packet RAM
		HAL_GPIO_WritePin(ADF7242_CS_GPIO_Port, ADF7242_CS_Pin, GPIO_PIN_RESET);
		HAL_SPI_Transmit_IT(&hspi1, header, sizeof(header)/sizeof(header[0]));
		HAL_GPIO_WritePin(ADF7242_CS_GPIO_Port, ADF7242_CS_Pin, GPIO_PIN_SET);
		ADF_set_Tx_mode();
	}
	else if(keybit_type == packet_type_keybit_chosen_CRC){
		//packet length + Hamming-code (1byte) + CRC (4byte) + index (1byte)
		packet_total_length+=6;
		uint8_t header[] = {0x10, packet_total_length, packet_type_keybit_chosen_CRC, dest_ID = ptrdev->ID , source_ID, Hamming, CRC_array[0],CRC_array[1],CRC_array[2],CRC_array[3], ptrdev->keywords_128bit};

		// Write data to packet RAM
		HAL_GPIO_WritePin(ADF7242_CS_GPIO_Port, ADF7242_CS_Pin, GPIO_PIN_RESET);
		HAL_SPI_Transmit_IT(&hspi1, header, sizeof(header)/sizeof(header[0]));
		HAL_GPIO_WritePin(ADF7242_CS_GPIO_Port, ADF7242_CS_Pin, GPIO_PIN_SET);
		ADF_set_Tx_mode();
	}

	else if(keybit_type == packet_type_keybit_CRC_ok){
		uint8_t header[] = {0x10, packet_total_length, packet_type_keybit_CRC_ok, dest_ID = ptrdev->ID , source_ID};

		// Write data to packet RAM
		HAL_GPIO_WritePin(ADF7242_CS_GPIO_Port, ADF7242_CS_Pin, GPIO_PIN_RESET);
		HAL_SPI_Transmit_IT(&hspi1, header, sizeof(header)/sizeof(header[0]));
		HAL_GPIO_WritePin(ADF7242_CS_GPIO_Port, ADF7242_CS_Pin, GPIO_PIN_SET);
		ADF_set_Tx_mode();
	}
	else if(keybit_type == packet_type_keybit_CRC_bad){
		uint8_t header[] = {0x10, packet_total_length, packet_type_keybit_CRC_bad, dest_ID = ptrdev->ID , source_ID};

		// Write data to packet RAM
		HAL_GPIO_WritePin(ADF7242_CS_GPIO_Port, ADF7242_CS_Pin, GPIO_PIN_RESET);
		HAL_SPI_Transmit_IT(&hspi1, header, sizeof(header)/sizeof(header[0]));
		HAL_GPIO_WritePin(ADF7242_CS_GPIO_Port, ADF7242_CS_Pin, GPIO_PIN_SET);
		ADF_set_Tx_mode();
	}

	else if(keybit_type == packet_type_reply){
		uint8_t header[] = {0x10, packet_total_length, packet_type_reply, dest_ID = ptrdev->ID , source_ID};

		// Write data to packet RAM
		HAL_GPIO_WritePin(ADF7242_CS_GPIO_Port, ADF7242_CS_Pin, GPIO_PIN_RESET);
		HAL_SPI_Transmit_IT(&hspi1, header, packet_total_length);
		HAL_GPIO_WritePin(ADF7242_CS_GPIO_Port, ADF7242_CS_Pin, GPIO_PIN_SET);
		ADF_set_Tx_mode();
	}

}

void playAudio(){
	uint16_t sample;
	uint8_t cbuf_ret = 0;
	cbuf_size = circular_buf_size(audio_buffer_handle_t);
	// Check if circular buffer is filled with samples
	if(cbuf_size){
		cbuf_ret = circular_buf_get(audio_buffer_handle_t, &sample);
		HAL_DAC_SetValue(&hdac, DAC1_CHANNEL_1, DAC_ALIGN_8B_R, sample);
	}
}

uint8_t Hamming_create(uint8_t key){
	uint8_t bit_0 =  key	 & 0x01;
	uint8_t bit_1 = (key>>1) & 0x01;
	uint8_t bit_2 = (key>>2) & 0x01;
	uint8_t bit_3 = (key>>3) & 0x01;
	uint8_t bit_4 = (key>>4) & 0x01;
	uint8_t bit_5 = (key>>5) & 0x01;
	uint8_t bit_6 = (key>>6) & 0x01;
	uint8_t bit_7 = (key>>7) & 0x01;

	uint8_t parity_0 = bit_0 ^ bit_1 ^ bit_3 ^ bit_4 ^ bit_6;
	uint8_t parity_1 = bit_0 ^ bit_2 ^ bit_3 ^ bit_5 ^ bit_6;
	uint8_t parity_2 = bit_1 ^ bit_2 ^ bit_3 ^ bit_7;
	uint8_t parity_3 = bit_4 ^ bit_5 ^ bit_6 ^ bit_7;

	uint8_t Tx_code = (parity_3 * 8) + (parity_2 * 4) + (parity_1 * 2) + parity_0;
	Tx_code = 0x0F & Tx_code;
	return Tx_code;
}

uint8_t Hamming_correct(uint8_t Tx_code, uint8_t key){
	uint8_t bit_0 =  key 	 & 0x01;
	uint8_t bit_1 = (key>>1) & 0x01;
	uint8_t bit_2 = (key>>2) & 0x01;
	uint8_t bit_3 = (key>>3) & 0x01;
	uint8_t bit_4 = (key>>4) & 0x01;
	uint8_t bit_5 = (key>>5) & 0x01;
	uint8_t bit_6 = (key>>6) & 0x01;
	uint8_t bit_7 = (key>>7) & 0x01;

	uint8_t parity_0 = bit_0 ^ bit_1 ^ bit_3 ^ bit_4 ^ bit_6;
	uint8_t parity_1 = bit_0 ^ bit_2 ^ bit_3 ^ bit_5 ^ bit_6;
	uint8_t parity_2 = bit_1 ^ bit_2 ^ bit_3 ^ bit_7;
	uint8_t parity_3 = bit_4 ^ bit_5 ^ bit_6 ^ bit_7;

	uint8_t Rx_code = (parity_3 * 8) + (parity_2 * 4) + (parity_1 * 2) + parity_0;

	if (Rx_code != Tx_code){
		uint8_t control_0 = 0;
		uint8_t control_1 = 0;
		uint8_t control_2 = 0;
		uint8_t control_3 = 0;

		if (parity_0 != (Tx_code & 0x01))
			control_0 = 1;
		if (parity_1 != ((Tx_code>>1) & 0x01))
			control_1 = 1;
		if (parity_2 != ((Tx_code>>2) & 0x01))
			control_2 = 1;
		if (parity_3 != ((Tx_code>>3) & 0x01))
			control_3 = 1;

		uint8_t control = (control_3 * 8) + (control_2 * 4) + (control_1 * 2) + control_0;

		// Key correction
		switch(control)	{
			case 3:
				key ^= 1UL << 0;
				break;
			case 5:
				key ^= 1UL << 1;
				break;
			case 6:
				key ^= 1UL << 2;
				break;
			case 7:
				key ^= 1UL << 3;
				break;
			case 9:
				key ^= 1UL << 4;
				break;
			case 10:
				key ^= 1UL << 5;
				break;
			case 11:
				key ^= 1UL << 6;
				break;
			case 12:
				key ^= 1UL << 7;
				break;
		}
	}
	return key;
}

void CRC_create(device *ptrdev){
	CRC_sum = HAL_CRC_Calculate(&hcrc, ptrdev->key_CRC_128bit, 4);
	// LSB to MSB (0 to 3)
	for(int i=0; i<4; i++)	{
		CRC_array[3-i] = (CRC_sum >> (i*8));
	}
}

uint8_t CRC_check(device *ptrdev){
	CRC_c = HAL_CRC_Calculate(&hcrc, ptrdev->key_CRC_128bit, 4);
	for (int i=0; i < 4; i++){
		CRC_sum = (CRC_sum << 8) | CRC_array[i];
	}
	return (CRC_c==CRC_sum?1:0);
}



/* USER CODE END 4 */
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
