ruben-wilssens/master_20-21/Master_1.0/Core/Inc/OLED.h

/*
 *  OLED.c
 *  Created on: April 2021
 *  Author: Ruben Wilssens & Victor Van der Elst
 *
 */

#ifndef INC_OLED_H_
#define INC_OLED_H_

#ifdef __cplusplus
extern C {
#endif

/**
 * The OLED uses I2C for communication
 *
 * Default pinout
 *
 * OLED	  |STM32F4    |DESCRIPTION
 * SDA    |PB7        |I2C Serial Data
 * SCL    |PB6        |I2C Serial Clock
 *
 */

/* Includes ------------------------------------------------------------------*/
#include "ssh1106.h"
#include "ssh1106_fonts.h"
#include "ssh1106_conf.h"
#include "stm32f4xx_hal.h"
#include "main.h"

/* Defines -------------------------------------------------------------------*/

/* Functions -----------------------------------------------------------------*/
void OLED_print_credits(void);
void OLED_print_status(char);
void OLED(void);
void OLED_init(void);
void OLED_clear_screen(void);
void OLED_update(void);
void OLED_shutdown(void);

void OLED_print_text(char [], uint8_t, uint8_t);
void OLED_print_variable(char [], uint32_t, uint8_t, uint8_t);
void OLED_print_hexadecimal(char[], uint32_t, uint8_t, uint8_t);
void OLED_print_binary(char[], uint8_t, uint8_t, uint8_t);

#ifdef __cplusplus
}
#endif

#endif /* INC_OLED_H_ */
