ruben-wilssens/master_20-21/(commit log)

2021-04-08 Acknowledgement packet in RX + struct implementation of devices
    Minor:
    - sample rate fix
    - code clean up
    [ADF7242.c, Master.ioc]
2021-04-11 Encryption setting audio + function expansion for packettype
    - Both encrypted and non-encrypted audio work when TX selects preferred encryption_setting
    - Packet_length fix (with RSSI_TEST)
    - Code cleanup + start expansion for network layer packets
    [main.c]
2021-04-12 TX key generation 1 device
    - Tx generates 32-bit keys continuously with RSS of received ack packets
    - 32-bit key send over USB CDC
    - no key generation or reconciliation on Rx yet
2021-04-15 RX key generation without reconciliation
    - adding logic for RX key generation
    - adding different packet types
    -possible bug: receiving Hamming & CRC packet on RX
    [main.c]
2021-04-21 OLED libraries
    - driver fixes
    - OLED library/functions
    - debug screen
    -bugs: sometimes device get stuck and can't receive messages (RC_status != RX? maar PHY_READY?)
    [ADF7242.c, OLED.c, OLED.h, main.c, main.h, ssh1106.c, ssh1106.h, ssh1106_conf.h]
2021-04-24 Key generation TX+RX + OLED display expansion
    - keys continuously generated on TX and RX can build keys aswell (though high bit disagreement)
    - OLED debugging screen: packets TX, packets RX, packets/s (updating every second can cause packet loss)
    - power button working with standby mode
2021-04-24 Key generation bugfixes: Hamming-code and printing to terminal
    [main.c]
2021-04-25 Key generation
    - bugs on CRC_reply
    [Master.ioc, main.c]
2021-05-03 CRC index + key distribution + multi-user (bugs)
    - CRC index for key errors when CRC or CRC_reply is not received
    - added list of authorized users for key algorithm
    - added key distribution function when device becomes TX
    Known bugs:
    - switching from TX -> RX cannot receive packets (PHY_RDY mode?) but switching to TX again can transmit audio correctly
    - with key distribution enabled, audio packets are not received on RX
    [main.c]
2021-05-06 OLED menu update + LBO interrupt
    - cyclic menu with parameters
    - updating parameters with buttons
    Bugs:
    - TX won't send packets if OLED is enabled
    - two way communication
    Not tested: multiple devices
    [OLED.c, OLED.h, main.c, main.h]
2021-05-06 OLED fix
    Bugs with two way communication remain
    TODO: in packet received, ADF_set_RX not 100% correct? (~ encryption OFF does not work if receiver does not reply with packets (and hence uses turnaround mode to go automatically to RX after TX)
    [main.c]
2021-06-09 OLED menu USB logging + extra comments/cleanup
    @TODO:
    -multi-user
    -TX/RX switch bugs ADF
    -encryption off without replies (no reply = no automatic turnaround mode = no switch to RX)
    [OLED.c, OLED.h, main.c, ssh1106.c, ssh1106.h]
